mizamae/SafeAccess/media/Board 1_regulator.png

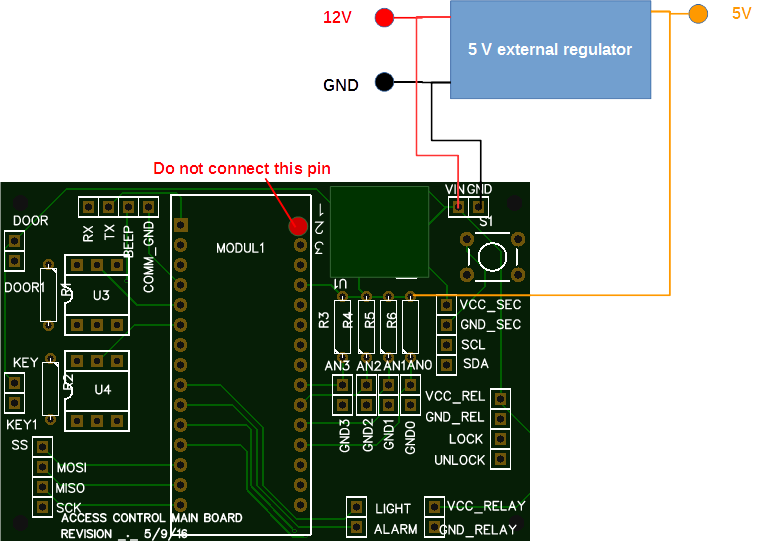
media/Board 1_regulator.png
